klckr33/stm32-smart-sensor-dev-board/docs/images/schematic-gpio-header.png

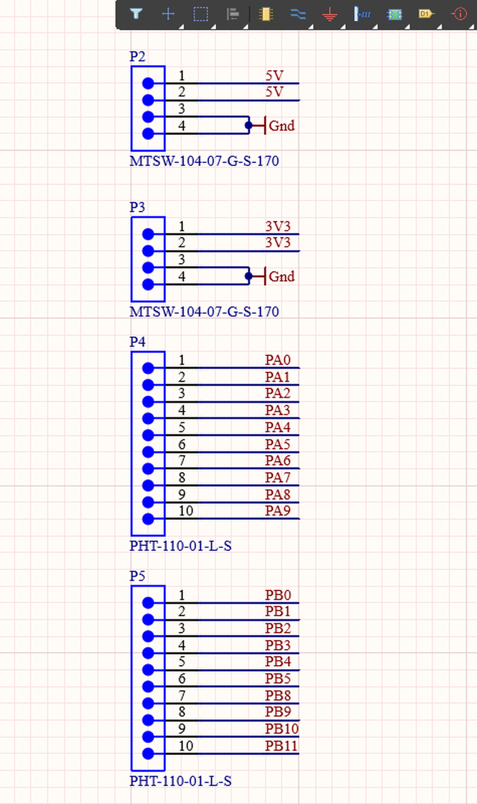
docs/images/schematic-gpio-header.png
