klckr33/stm32-smart-sensor-dev-board/docs/images/schematic-sensor-display.png

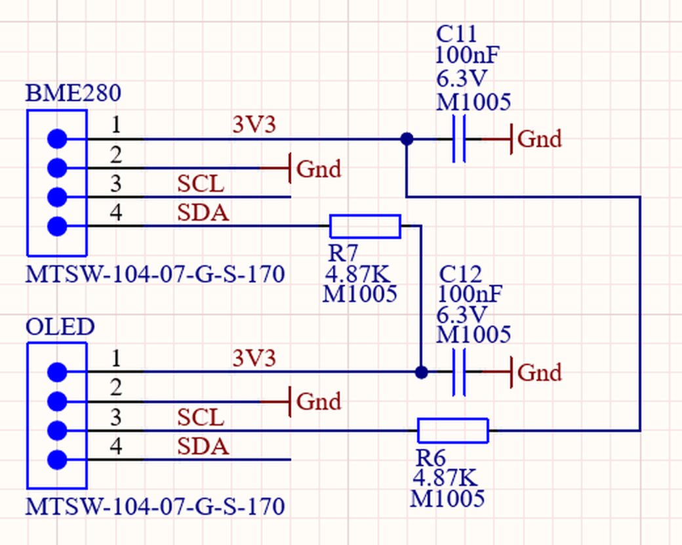
docs/images/schematic-sensor-display.png
