klckr33/stm32-smart-sensor-dev-board/(list of files, drawings)

Other design files:
hardware/altium/01_Power.SchDoc
hardware/altium/02_MCU.SchDoc
hardware/altium/03_Sensor_Display.SchDoc
hardware/altium/04_GPIO_Header.SchDoc
hardware/altium/Akilli_Sensor_Dugumu.PcbDoc
hardware/altium/Akilli_Sensor_Dugumu.PrjPcb
