klckr33/stm32-smart-sensor-dev-board/(notices)

Notices in the files:
README.md:
License: MIT
